SG-O/MiniFeedPCB/README.MD

# Main PCB for automated SMT Feeder #

## Documentation ##

You can find the manufacturing documentation [here.](https://github.com/SG-O/MiniFeedPCB/tree/master/Doc)

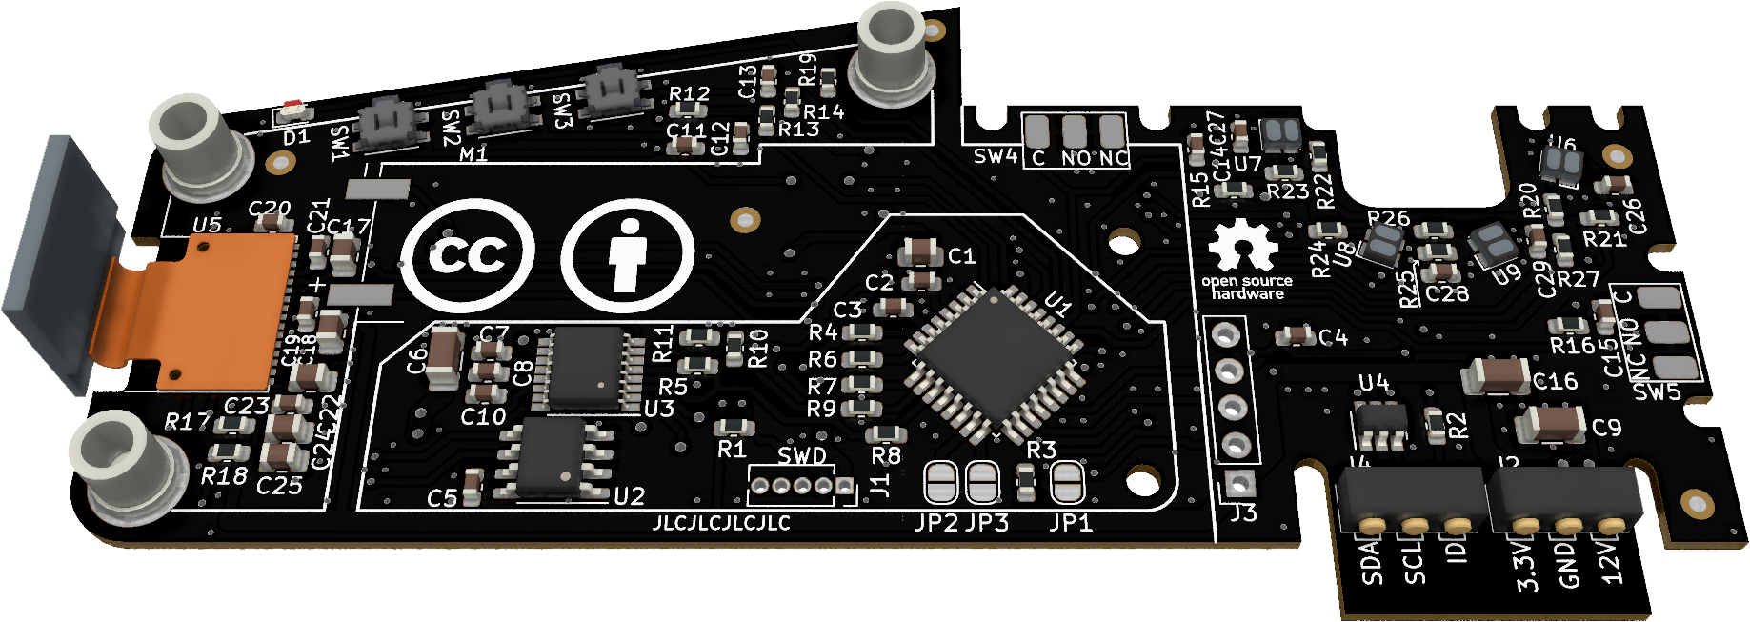
[picture p1: Doc/MiniFeed.png]
