SG-O/MiniFeedPCB/Doc/README.MD

# Manufacturing Documentation #

## Schematic ##

You can view the schematic [here.](https://github.com/SG-O/MiniFeedPCB/blob/master/Doc/MiniFeed.pdf "Schematic")

## Gerber Files ##

Gerber files for this board can be found [here.](https://github.com/SG-O/MiniFeedPCB/releases "Releases")

## BOM ##

The BOM is available [here.](https://github.com/SG-O/MiniFeedPCB/blob/master/Doc/MiniFeed.csv "BOM")

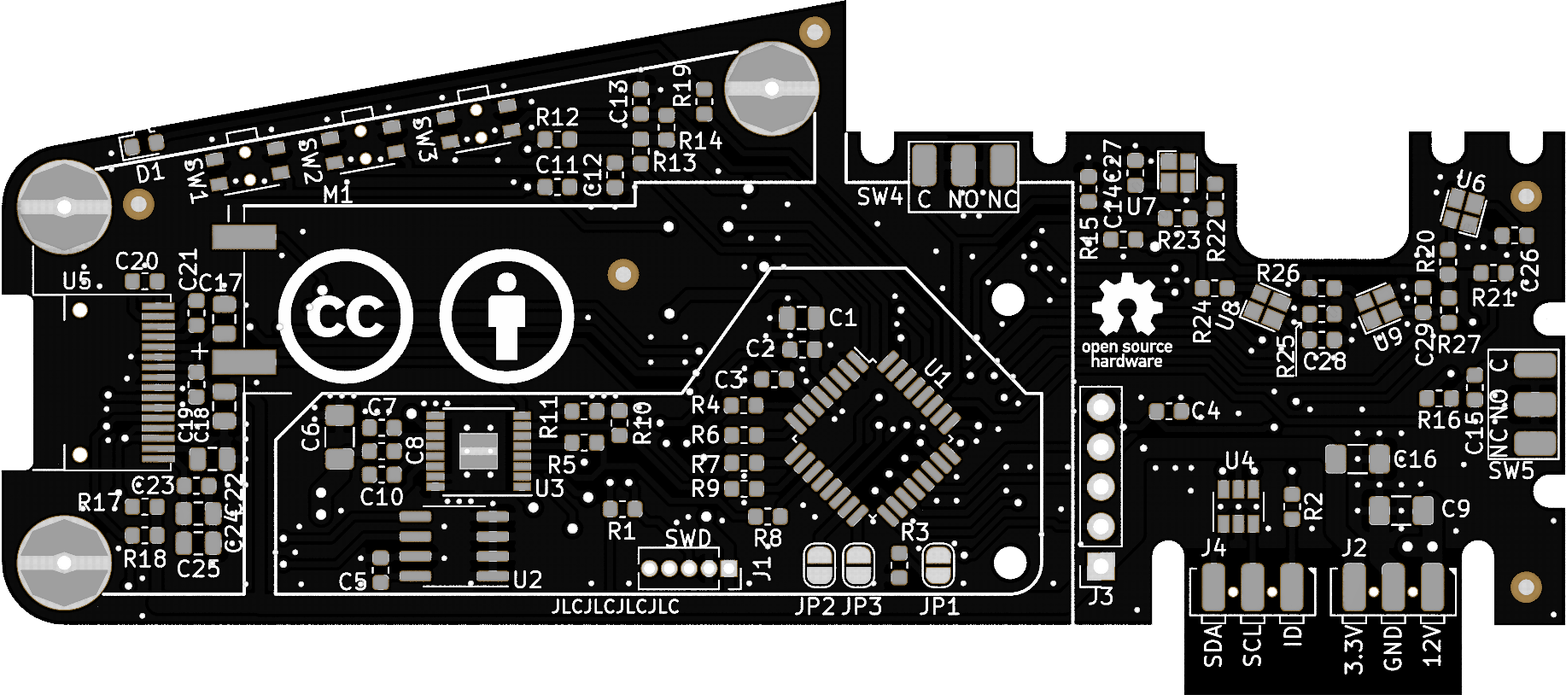
[picture p2: Doc/MiniFeedFront.png]
