SG-O/MiniFeedPCB/Doc/MiniFeedBack.png

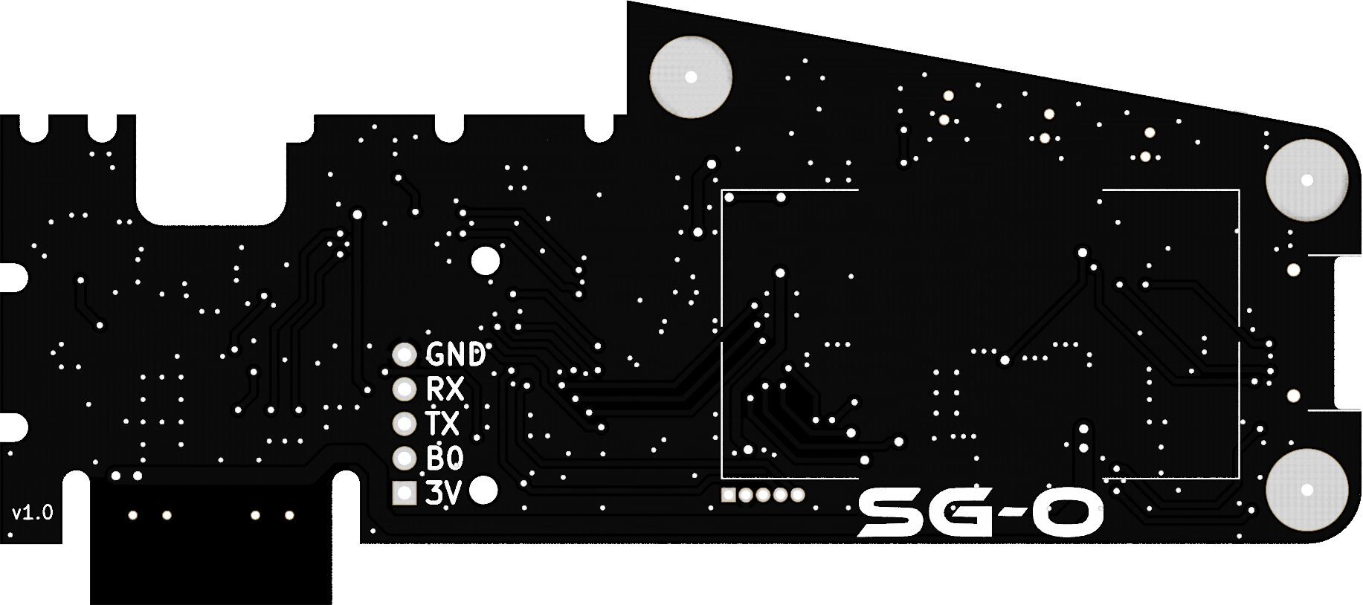
Doc/MiniFeedBack.png
