SG-O/MiniFeedPCB/MiniFeed.png

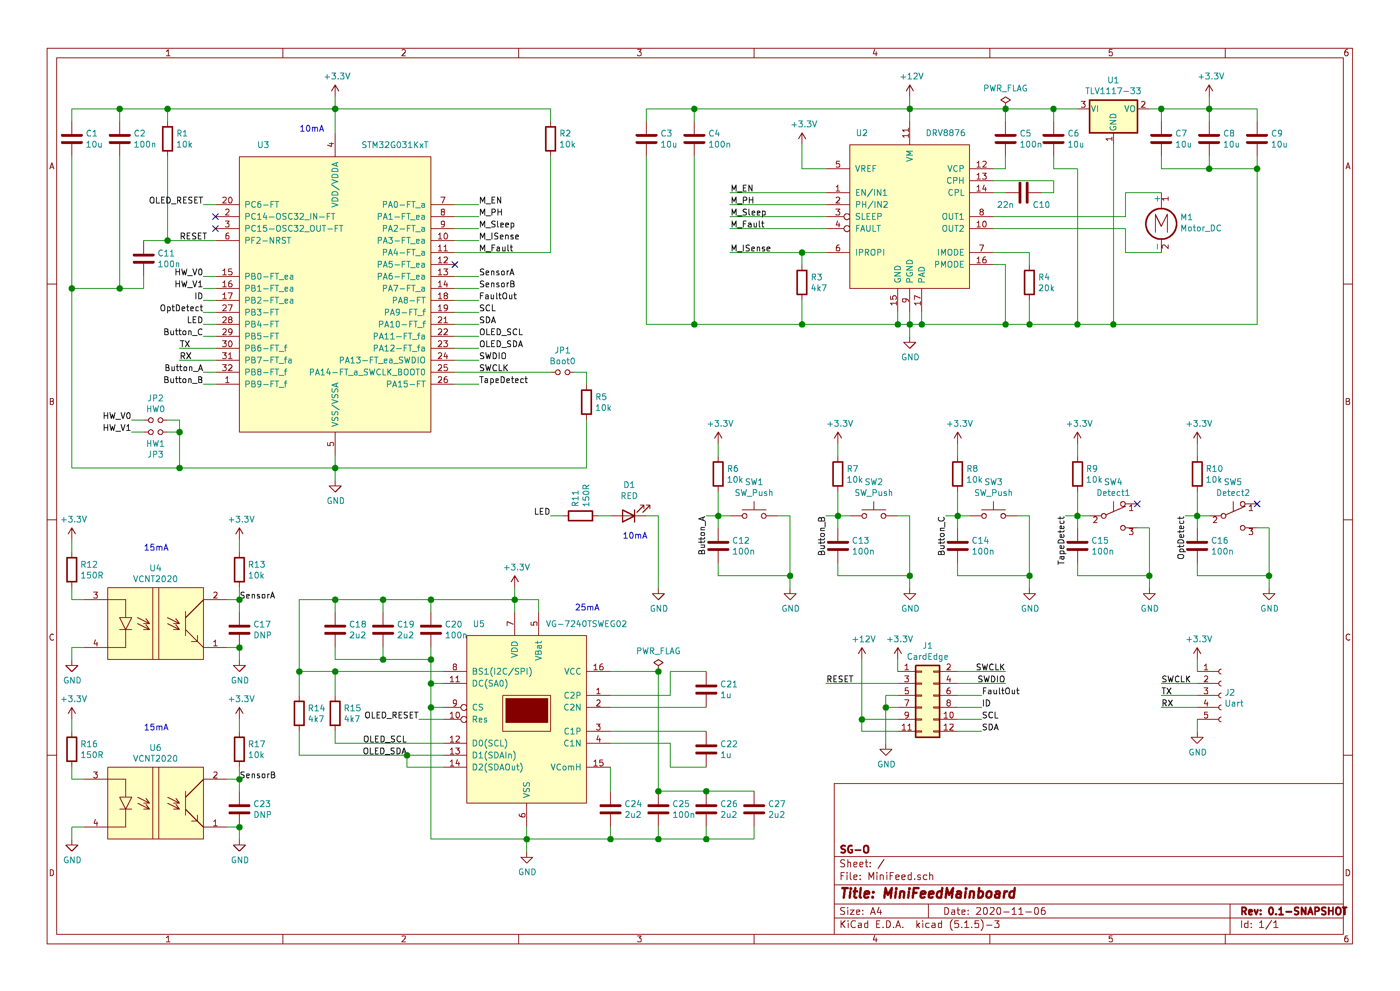
MiniFeed.png
