SG-O/MiniFeedPCB/Doc/MiniFeed.pdf

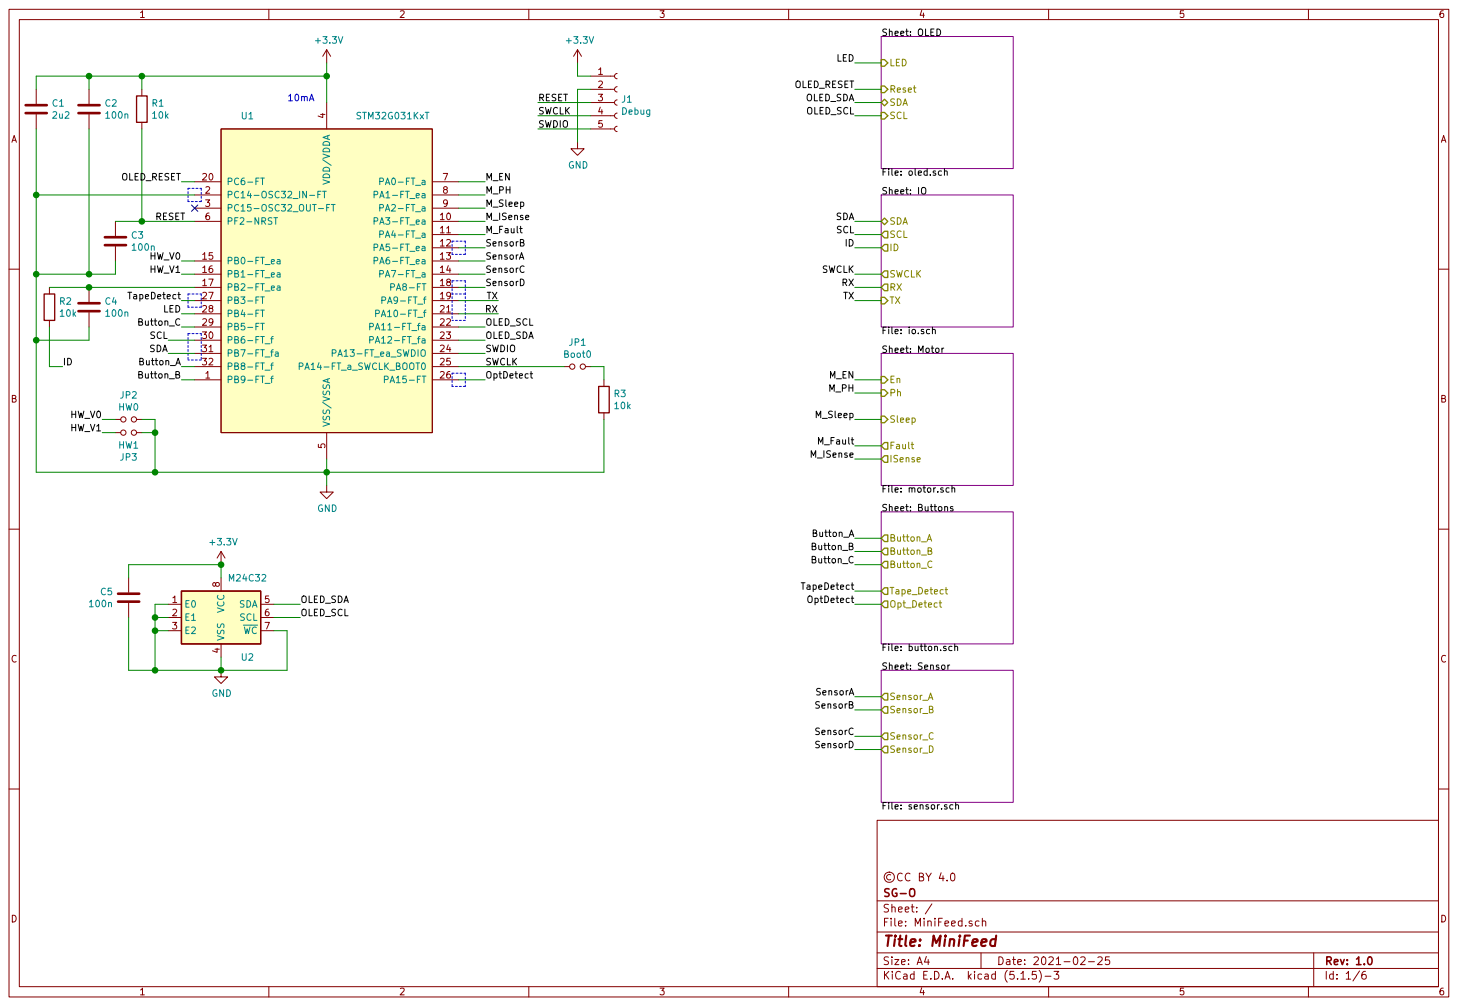
[picture p5: page 1]

File: oled.sch
File: io.sch SCL
Opt_Detect Sheet: Motor File: motor.sch EnPhSleep Fault

Sheet: Buttons File: button.sch Button_A

Button_B
Button_C
©CC BY 4.0 Sheet: Sensor File: sensor.sch Sensor_A

File: MiniFeed.sch Sheet: / SG-O

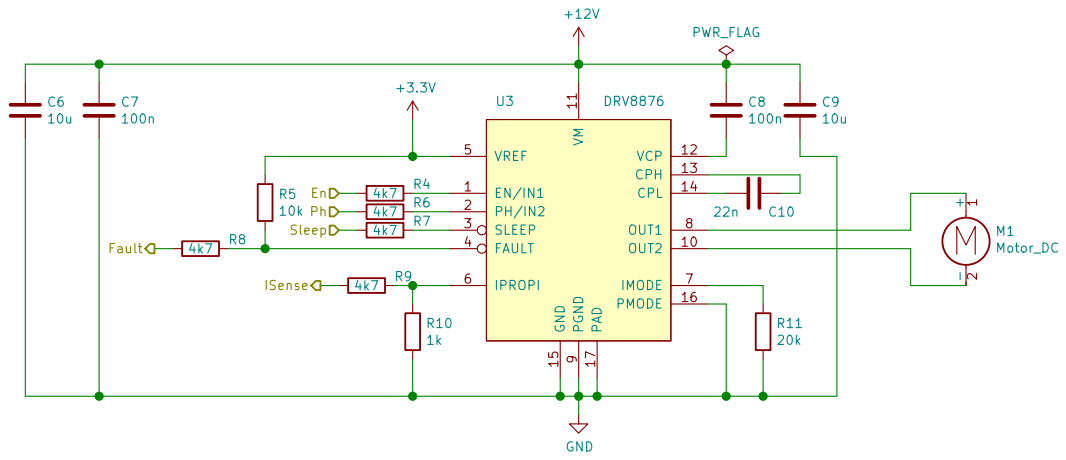
[picture p6: page 2]

File: motor.sch Sheet: /Motor/ SG-O

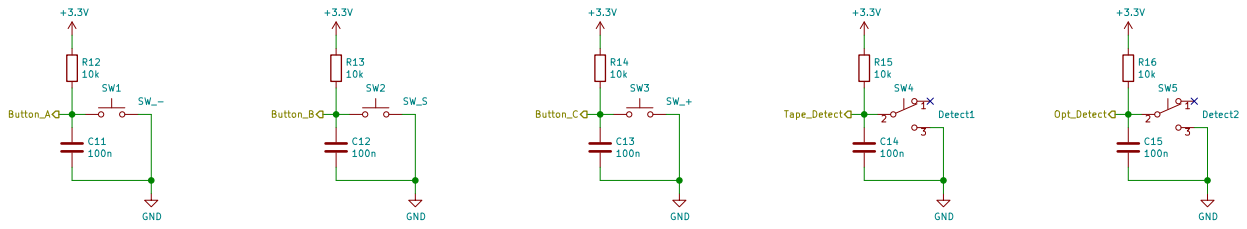
[picture p7: page 3]

File: button.sch Sheet: /Buttons/ SG-O

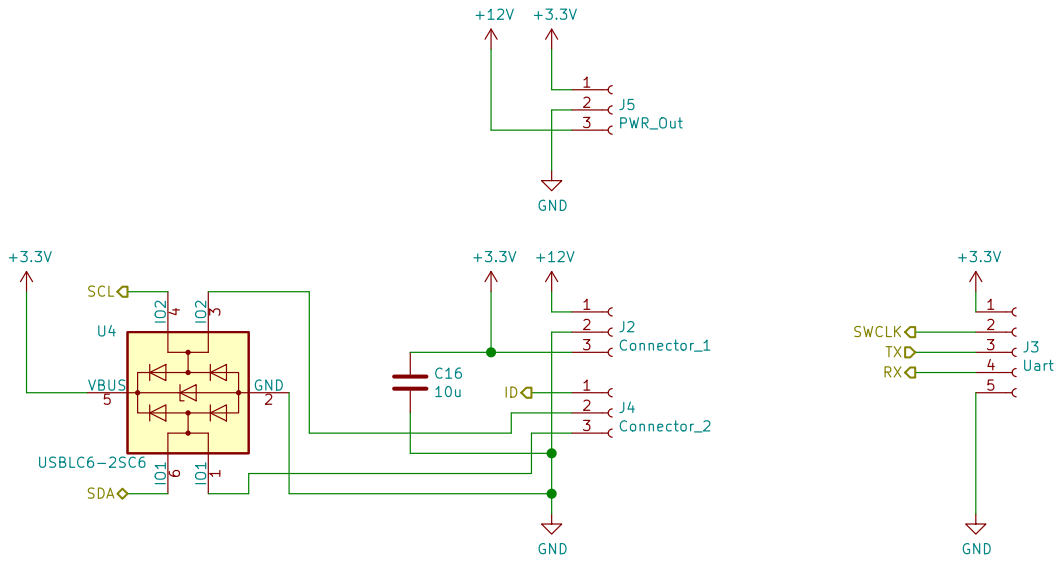
[picture p8: page 4]

File: io.sch Sheet: /IO/ SG-O

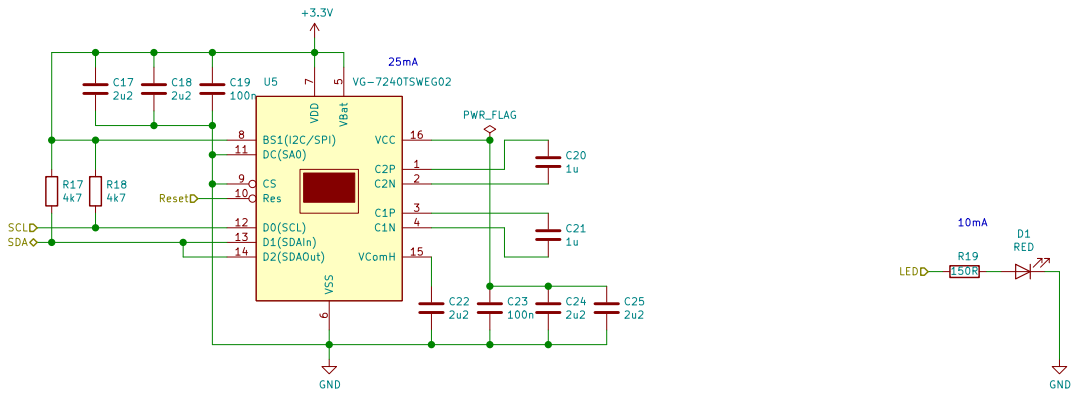
[picture p9: page 5]

File: oled.sch Sheet: /OLED/ SG-O

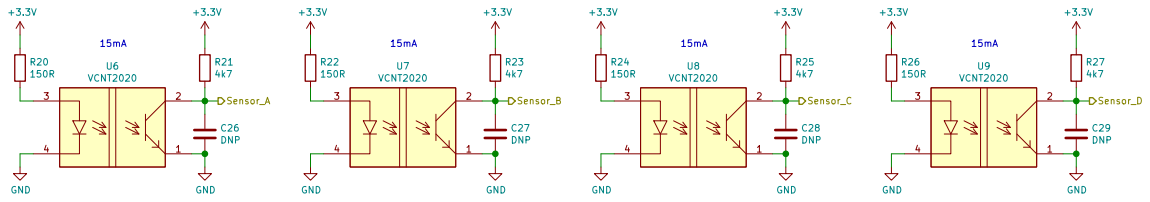
[picture p10: page 6]

File: sensor.sch Sheet: /Sensor/ SG-O
