SG-O/MiniFeedPCB/MiniFeed.kicad_pcb

## KiCad design MiniFeed.kicad_pcb (2021-02-24)

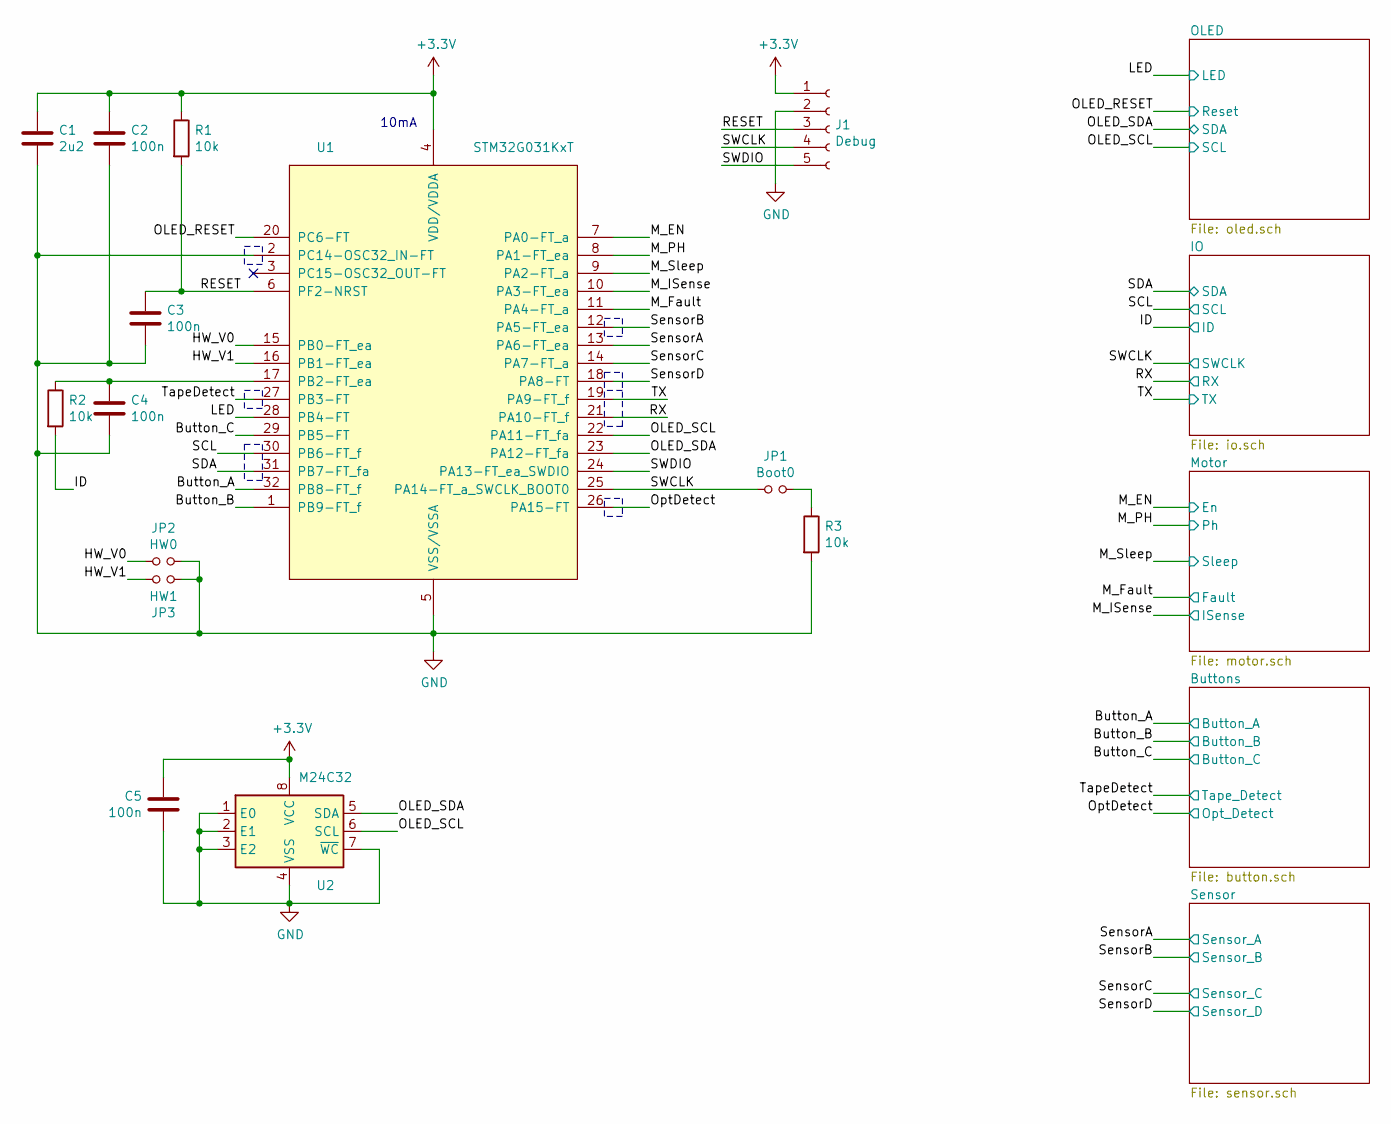
[picture p11: schematic MiniFeed.sch]

Parts:
C1: 2u2; C_0805_2012Metric; lcsc# C19110
C2, C3, C4, C5: 100n; C_0603_1608Metric; lcsc# C1591
J1: Debug; PinSocket_1x05_P1.27mm_Vertical
JP1: Boot0; SolderJumper-2_P1.3mm_Open_RoundedPad1.0x1.5mm
JP2: HW0; SolderJumper-2_P1.3mm_Open_RoundedPad1.0x1.5mm
JP3: HW1; SolderJumper-2_P1.3mm_Open_RoundedPad1.0x1.5mm
R1, R2, R3: 10k; R_0603_1608Metric; lcsc# C128781
U1: STM32G031KxT; LQFP-32_7x7mm_P0.8mm; lcsc# C432203
U2: M24C32; SOIC-8_3.9x4.9mm_P1.27mm; lcsc# C7998

Connections:
+3V3: C1.1, C2.1, C5.1, J1.1, R1.1, U1.4 (VDD/VDDA), U2.8 (VCC); also elsewhere on the board
/Button_A: U1.32 (PB8-FT_f); also elsewhere on the board
/Button_B: U1.1 (PB9-FT_f); also elsewhere on the board
/Button_C: U1.29 (PB5-FT); also elsewhere on the board
/HW_V0: JP2.1, U1.15 (PB0-FT_ea)
/HW_V1: JP3.1, U1.16 (PB1-FT_ea)
/ID: R2.2; also elsewhere on the board
/LED: U1.28 (PB4-FT); also elsewhere on the board
/M_EN: U1.7 (PA0-FT_a); also elsewhere on the board
/M_Fault: U1.11 (PA4-FT_a); also elsewhere on the board
/M_ISense: U1.10 (PA3-FT_ea); also elsewhere on the board
/M_PH: U1.8 (PA1-FT_ea); also elsewhere on the board
/M_Sleep: U1.9 (PA2-FT_a); also elsewhere on the board
/OLED_RESET: U1.20 (PC6-FT); also elsewhere on the board
/OLED_SCL: U1.22 (PA11-FT_fa), U2.6 (SCL); also elsewhere on the board
/OLED_SDA: U1.23 (PA12-FT_fa), U2.5 (SDA); also elsewhere on the board
/OptDetect: U1.26 (PA15-FT); also elsewhere on the board
/RESET: C3.1, J1.3, R1.2, U1.6 (PF2-NRST)
/RX: U1.21 (PA10-FT_f); also elsewhere on the board
/SCL: U1.30 (PB6-FT_f); also elsewhere on the board
/SDA: U1.31 (PB7-FT_fa); also elsewhere on the board
/SWCLK: J1.4, JP1.1, U1.25 (PA14-FT_a_SWCLK_BOOT0); also elsewhere on the board
/SWDIO: J1.5, U1.24 (PA13-FT_ea_SWDIO)
/SensorA: U1.13 (PA6-FT_ea); also elsewhere on the board
/SensorB: U1.12 (PA5-FT_ea); also elsewhere on the board
/SensorC: U1.14 (PA7-FT_a); also elsewhere on the board
/SensorD: U1.18 (PA8-FT); also elsewhere on the board
/TX: U1.19 (PA9-FT_f); also elsewhere on the board
/TapeDetect: U1.27 (PB3-FT); also elsewhere on the board
GND: C1.2, C2.2, C3.2, C4.2, C5.2, J1.2, JP2.2, JP3.2, R3.2, U1.2 (PC14-OSC32_IN-FT), U1.5 (VSS/VSSA), U2.1 (E0), U2.2 (E1), U2.3 (E2), U2.4 (VSS), U2.7 (~WC); also elsewhere on the board
unnamed: C4.1, R2.1, U1.17 (PB2-FT_ea)
unnamed: JP1.2, R3.1

Notes on the sheet:
10mA

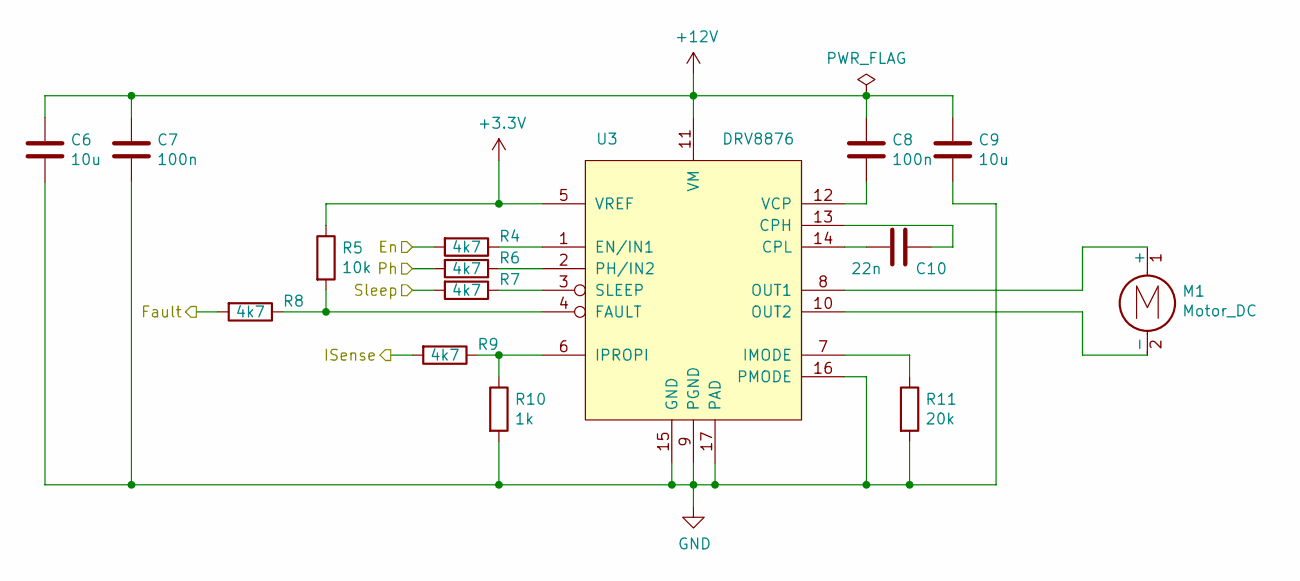
[picture p12: schematic motor.sch, MiniFeed]

Parts:
C6, C9: 10u; C_1206_3216Metric; lcsc# C14860
C7, C8: 100n; C_0603_1608Metric; lcsc# C1591
C10: 22n; C_0603_1608Metric; lcsc# C21122
M1: Motor_DC; MotorN20
R4, R6, R7, R8, R9: 4k7; R_0603_1608Metric; lcsc# C304093
R5: 10k; R_0603_1608Metric; lcsc# C128781
R10: 1k; R_0603_1608Metric; lcsc# C165976
R11: 20k; R_0603_1608Metric; lcsc# C135618
U3: DRV8876; HTSSOP-16-1EP_4.4x5mm_P0.65mm_EP3.4x5mm_Mask2.46x2.31mm_The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; lcsc# C575551

Connections:
+3V3: R5.1, U3.5 (VREF); also elsewhere on the board
+12V: C6.1, C7.1, C8.1, C9.1, U3.11 (VM); also elsewhere on the board
/M_EN: R4.2; also elsewhere on the board
/M_Fault: R8.2; also elsewhere on the board
/M_ISense: R9.2; also elsewhere on the board
/M_PH: R6.2; also elsewhere on the board
/M_Sleep: R7.2; also elsewhere on the board
GND: C6.2, C7.2, C9.2, R10.2, R11.2, U3.9 (PGND), U3.15 (GND), U3.16 (PMODE), U3.17 (PAD); also elsewhere on the board
unnamed: C8.2, U3.12 (VCP)
unnamed: C10.1, U3.13 (CPH)
unnamed: C10.2, U3.14 (CPL)
unnamed: M1.1 (+), U3.8 (OUT1)
unnamed: M1.2 (-), U3.10 (OUT2)
unnamed: R4.1, U3.1 (EN/IN1)
unnamed: R5.2, R8.1, U3.4 (FAULT)
unnamed: R6.1, U3.2 (PH/IN2)
unnamed: R7.1, U3.3 (SLEEP)
unnamed: R9.1, R10.1, U3.6 (IPROPI)
unnamed: R11.1, U3.7 (IMODE)

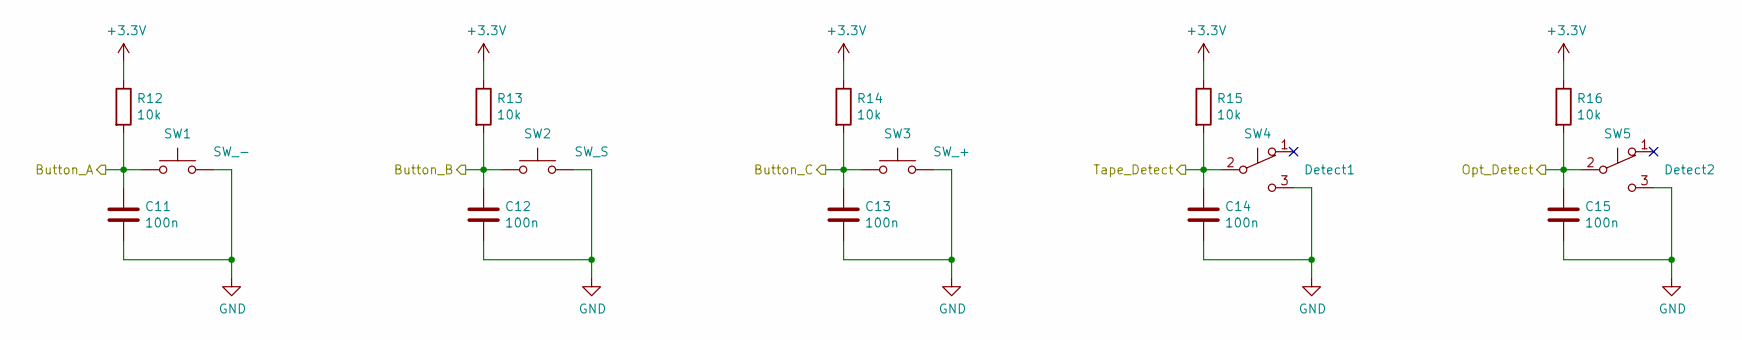
[picture p13: schematic button.sch, MiniFeed]

Parts:
C11, C12, C13, C14, C15: 100n; C_0603_1608Metric; lcsc# C1591
R12, R13, R14, R15, R16: 10k; R_0603_1608Metric; lcsc# C128781
SW1: SW_-; SW_SPST_TS-1065A-B3D4; lcsc# C498295
SW2: SW_S; SW_SPST_TS-1065A-B3D4; lcsc# C498295
SW3: SW_+; SW_SPST_TS-1065A-B3D4; lcsc# C498295
SW4: Detect1; MicroSwitchSMDLanding
SW5: Detect2; MicroSwitchSMDLanding

Connections:
+3V3: R12.1, R13.1, R14.1, R15.1, R16.1; also elsewhere on the board
/Button_A: C11.1, R12.2, SW1.1; also elsewhere on the board
/Button_B: C12.1, R13.2, SW2.1; also elsewhere on the board
/Button_C: C13.1, R14.2, SW3.1; also elsewhere on the board
/OptDetect: C15.1, R16.2, SW5.2 (B); also elsewhere on the board
/TapeDetect: C14.1, R15.2, SW4.2 (B); also elsewhere on the board
GND: C11.2, C12.2, C13.2, C14.2, C15.2, SW1.2, SW2.2, SW3.2, SW4.3 (C), SW5.3 (C); also elsewhere on the board

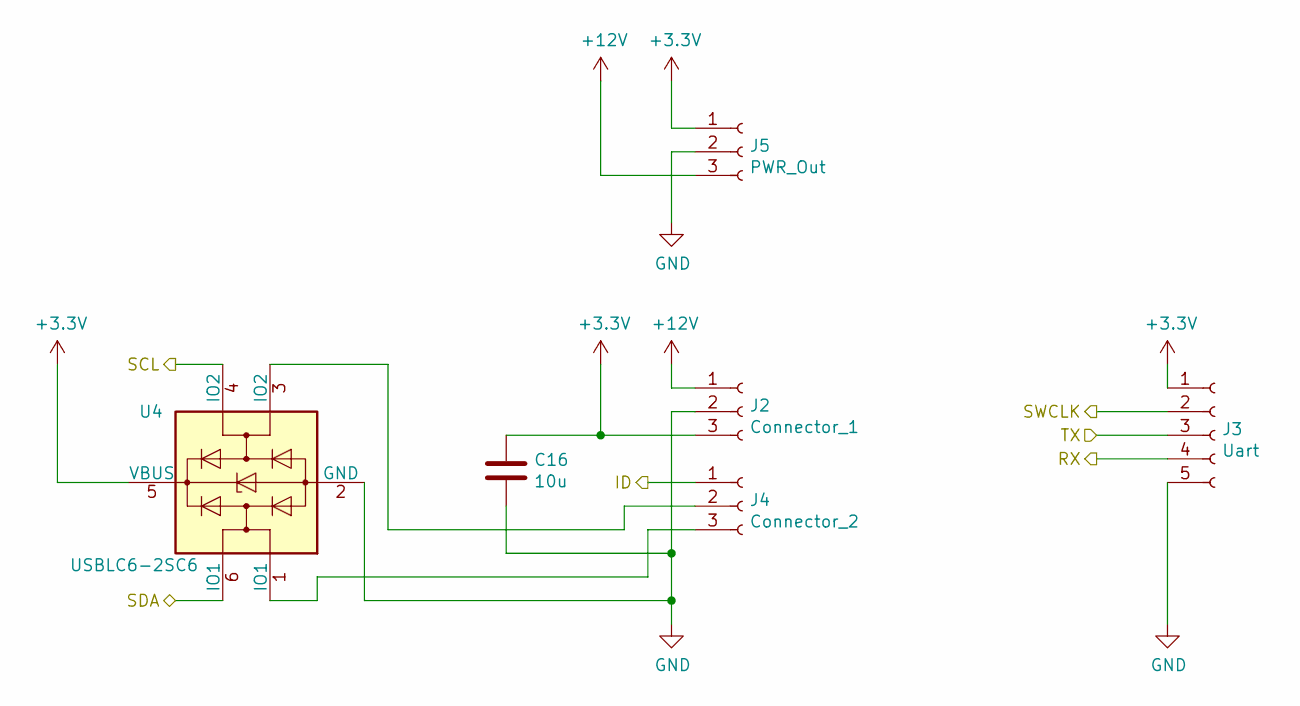
[picture p14: schematic io.sch, MiniFeed]

Parts:
C16: 10u; C_1206_3216Metric; lcsc# C14860
J2: Connector_1; PogoTarget_P2.5
J3: Uart; PinSocket_1x05_P2.54mm_Vertical
J4: Connector_2; PogoTarget_P2.5
J5: PWR_Out; PinSocket_1x03_P1.27mm_Vertical_SMD_Pin1Left
U4: USBLC6-2SC6; SOT-23-6; lcsc# C558442

Connections:
+3V3: C16.1, J2.3, J3.1, J5.1, U4.5 (VBUS); also elsewhere on the board
+12V: J2.1, J5.3; also elsewhere on the board
/ID: J4.1; also elsewhere on the board
/RX: J3.4; also elsewhere on the board
/SCL: U4.4 (IO2); also elsewhere on the board
/SDA: U4.6 (IO1); also elsewhere on the board
/SWCLK: J3.2; also elsewhere on the board
/TX: J3.3; also elsewhere on the board
GND: C16.2, J2.2, J3.5, J5.2, U4.2 (GND); also elsewhere on the board
unnamed: J4.2, U4.3 (IO2)
unnamed: J4.3, U4.1 (IO1)

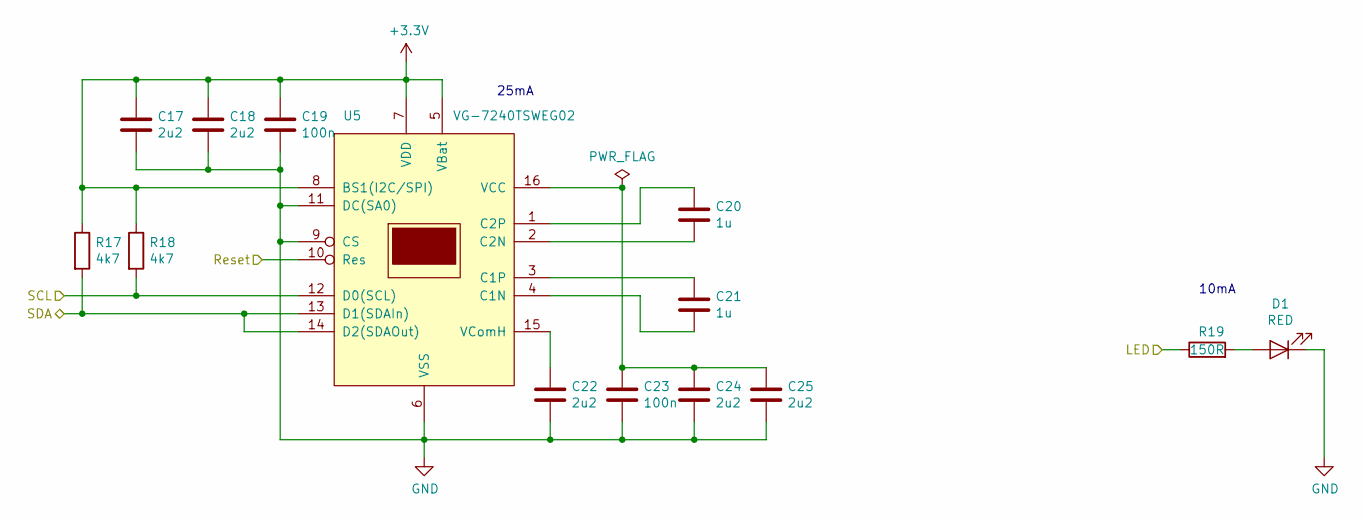
[picture p15: schematic oled.sch, MiniFeed]

Parts:
C17, C18, C22, C24, C25: 2u2; C_0805_2012Metric; lcsc# C19110
C19, C23: 100n; C_0603_1608Metric; lcsc# C1591
C20, C21: 1u; C_0603_1608Metric; lcsc# C29936
D1: RED; LED_0603_1608Metric_SIDE; lcsc# C125114
R17, R18: 4k7; R_0603_1608Metric; lcsc# C304093
R19: 150R; R_0603_1608Metric; lcsc# C217745
U5: VG-7240TSWEG02; VG-7240TSWEG02-mirror

Connections:
+3V3: C17.1, C18.1, C19.1, R17.1, R18.1, U5.5 (VBat), U5.7 (VDD), U5.8 (BS1(I2C/SPI)); also elsewhere on the board
/LED: R19.1; also elsewhere on the board
/OLED_RESET: U5.10 (Res); also elsewhere on the board
/OLED_SCL: R18.2, U5.12 (D0(SCL)); also elsewhere on the board
/OLED_SDA: R17.2, U5.13 (D1(SDAIn)), U5.14 (D2(SDAOut)); also elsewhere on the board
GND: C17.2, C18.2, C19.2, C22.2, C23.2, C24.2, C25.2, D1.1 (K), U5.6 (VSS), U5.9 (CS), U5.11 (DC(SA0)); also elsewhere on the board
unnamed: C20.1, U5.1 (C2P)
unnamed: C20.2, U5.2 (C2N)
unnamed: C21.1, U5.3 (C1P)
unnamed: C21.2, U5.4 (C1N)
unnamed: C22.1, U5.15 (VComH)
unnamed: C23.1, C24.1, C25.1, U5.16 (VCC)
unnamed: D1.2 (A), R19.2

Notes on the sheet:
25mA
10mA

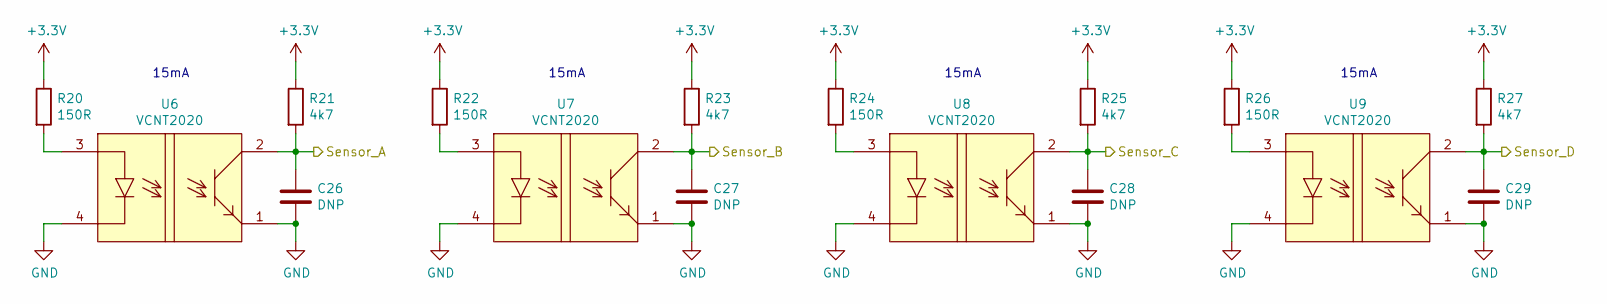
[picture p16: schematic sensor.sch, MiniFeed]

Parts:
C26, C27, C28, C29: DNP; C_0603_1608Metric
R20, R22, R24, R26: 150R; R_0603_1608Metric; lcsc# C217745
R21, R23, R25, R27: 4k7; R_0603_1608Metric; lcsc# C304093
U6, U7, U8, U9: VCNT2020; vcnt2020

Connections:
+3V3: R20.1, R21.1, R22.1, R23.1, R24.1, R25.1, R26.1, R27.1; also elsewhere on the board
/SensorA: C26.1, R21.2, U6.2; also elsewhere on the board
/SensorB: C27.1, R23.2, U7.2; also elsewhere on the board
/SensorC: C28.1, R25.2, U8.2; also elsewhere on the board
/SensorD: C29.1, R27.2, U9.2; also elsewhere on the board
GND: C26.2, C27.2, C28.2, C29.2, U6.1, U6.4, U7.1, U7.4, U8.1, U8.4, U9.1, U9.4; also elsewhere on the board
unnamed: R20.2, U6.3
unnamed: R22.2, U7.3
unnamed: R24.2, U8.3
unnamed: R26.2, U9.3

Notes on the sheet:
15mA

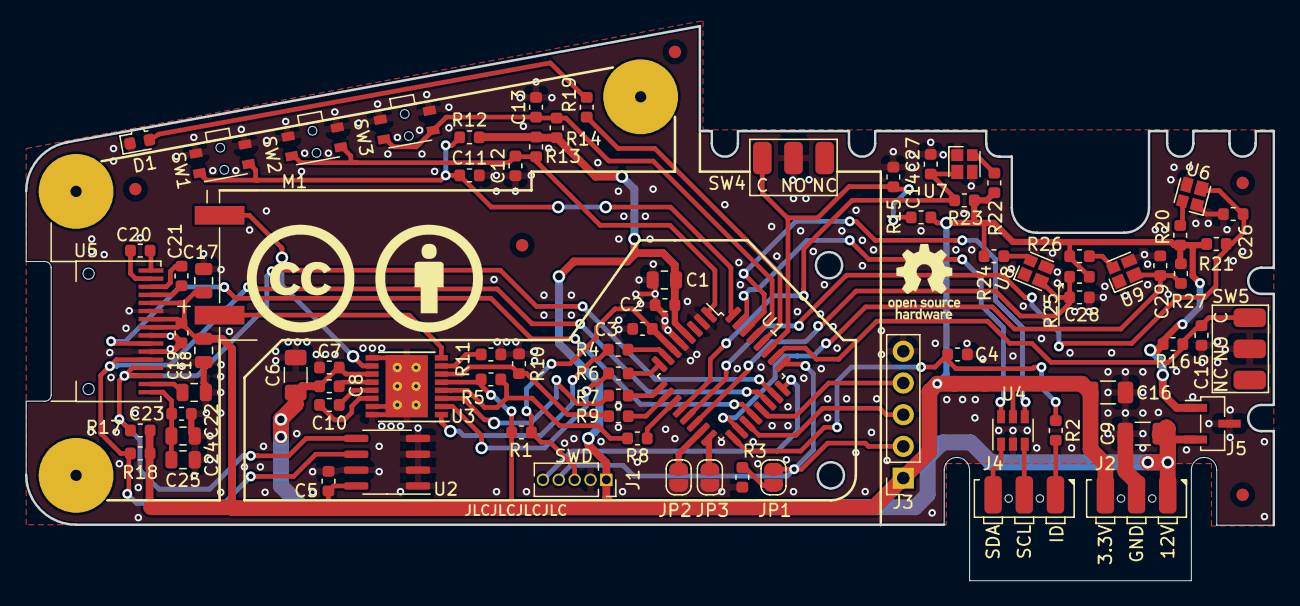
[picture p17: board MiniFeed.kicad_pcb from above]

Board: 2 copper layers, 100.0 x 44.4 mm, 92 parts (1 on the bottom side), 57 nets.

Other parts of the board:
Fid1, Fid2, Fid3, Fid4, Fid5: Fiducial_1mm_Mask2mm
G1: CC
G2: BY
G3: OSHW-Logo_5.7x6mm_SilkScreen
G4: SG-O; Logo_SG-O
Mech1, Mech2, Mech3: SolderStandoffM3x5
