SG-O/MiniFeedPCB/(commit log)

2020-12-17 Fixed LDO design: Added resistor to increase ESR for LDO. Added diode to LDO to protect the regulator if the input instantaneously is shorted to GND.
    Fixed the SCL trace.
    [MiniFeed.csv, MiniFeed.kicad_pcb, MiniFeed.sch]
2020-12-17 Made BOM beautiful and searchable
    [MiniFeed.csv]
2021-01-06 Updated CAD model
2021-01-31 Removed voltage regulator Added input protection Added more VCNT2020 sensors Fixed the motor driver overcurrent protection Replaced push buttons with smaller models
    [MiniFeed.csv, MiniFeed.sch, button.sch, io.sch, motor.sch, oled.sch, sensor.sch]
2021-01-31 Updated PCB design
    [MiniFeed.kicad_pcb]
2021-02-01 Moved C24 reference to resolve silkscreen collision
    [MiniFeed.kicad_pcb]
2021-02-01 Changed 0.33mm vias to 0.3mm
    [MiniFeed.kicad_pcb]
2021-02-24 Added an optional power output header Changed the resistors for the VCNT2020 to improve performance
    [MiniFeed.csv, MiniFeed.kicad_pcb, MiniFeed.sch, button.sch, io.sch, motor.sch, oled.sch, sensor.sch]
